GabiAndi/UNER_Tunel_de_viento/Simulacion/Fuente de corriente/Fuente de corriente.bmp

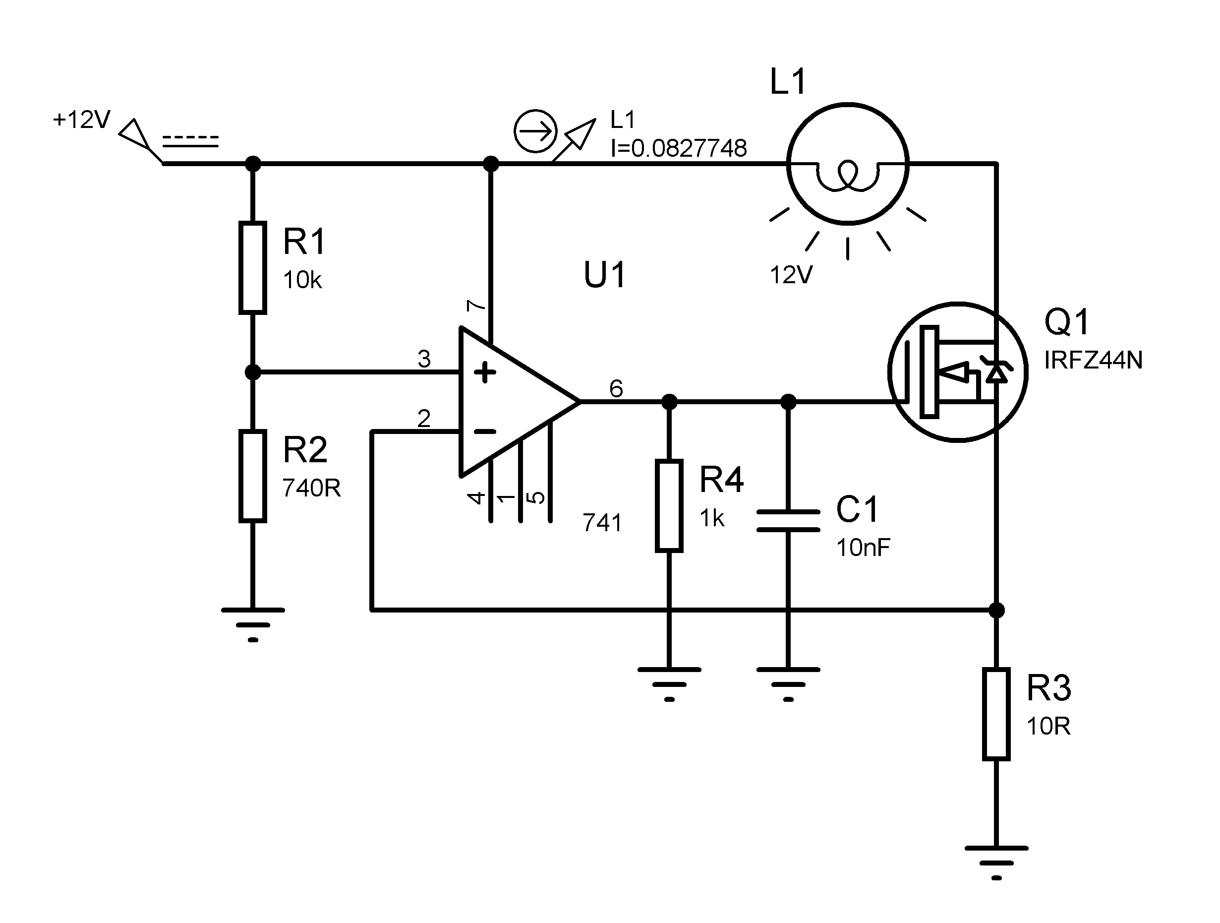
Simulacion/Fuente de corriente/Fuente de corriente.bmp
