GabiAndi/UNER_Tunel_de_viento/Simulacion/Linealizacion de NTC/Linealizacion de NTC.bmp

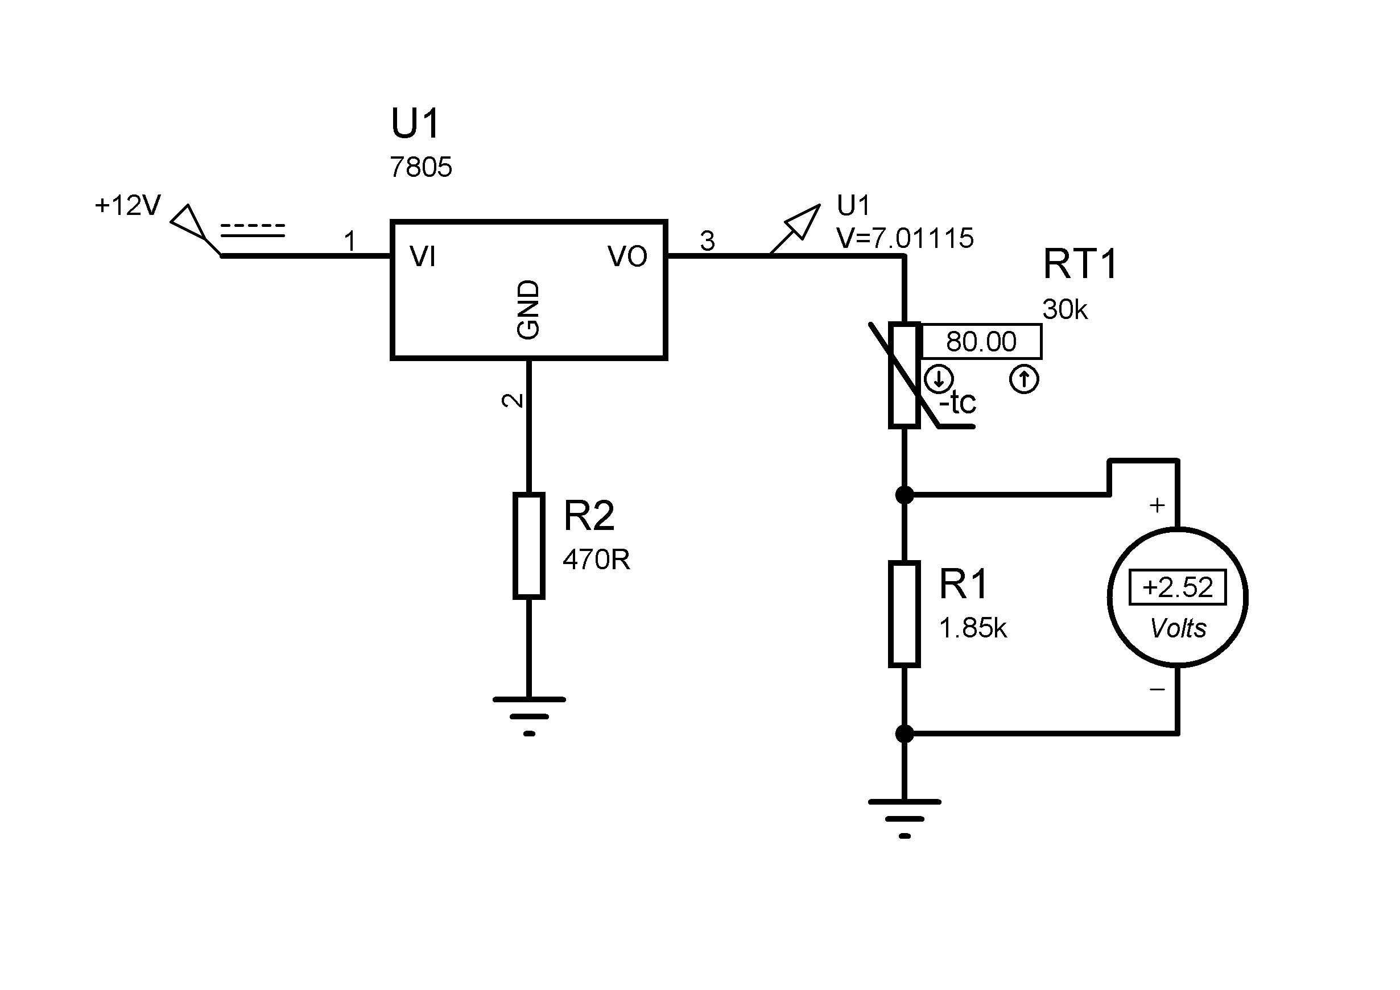
Simulacion/Linealizacion de NTC/Linealizacion de NTC.bmp
