GabiAndi/UNER_Tunel_de_viento/(list of files, drawings)

Other design files:
Simulacion/Clapeta/Clapeta.pdsprj
Simulacion/Fuente de corriente/Fuente de corriente.pdsprj
Simulacion/Linealizacion de NTC/Linealizacion de NTC.pdsprj
