GabiAndi/UNER_Tunel_de_viento/Esquemas/Esquematicos.sch

## EAGLE design Esquemas/Esquematicos.sch (2021-03-19)

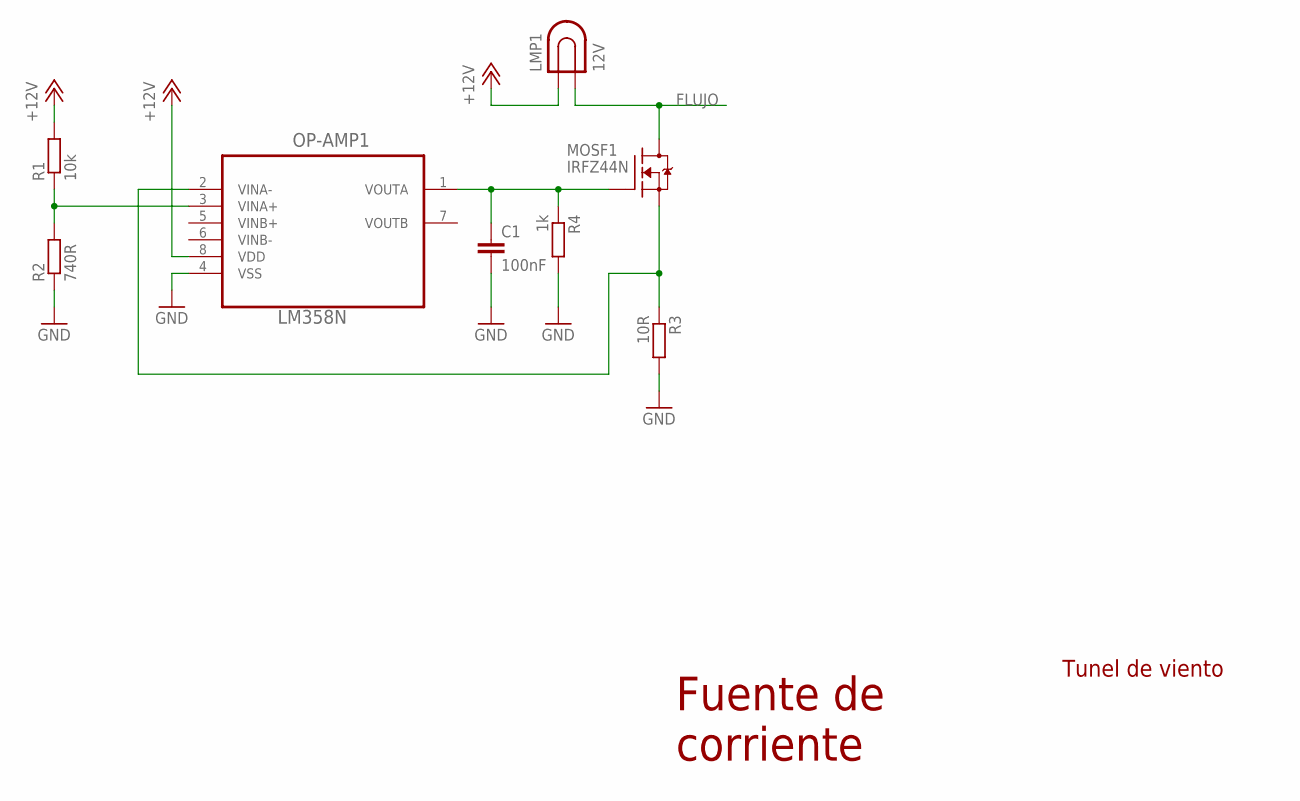
[picture p18: schematic Esquematicos.sch, sheet 1]

Parts:
C1: 100nF; C050-024X044
LMP1: 12V; LDH-5R
MOSF1: IRFZ44N; TO220V
OP-AMP1: LM358N; DIL8
R1: 10k; 0207/10
R2: 740R; 0207/10
R3: 10R; 0207/10
R4: 1k; 0207/10

Connections:
+12V: LMP1.1, OP-AMP1.8 (VDD), R1.2
FLUJO: LMP1.2, MOSF1.1 (D)
GND: C1.2, OP-AMP1.4 (VSS), R2.1, R3.2, R4.2
unnamed: OP-AMP1.3 (VINA+), R1.1, R2.2
unnamed: C1.1, MOSF1.2 (G), OP-AMP1.1 (VOUTA), R4.1
unnamed: MOSF1.3 (S), OP-AMP1.2 (VINA-), R3.1

Notes on the sheet:
Fuente de corriente
Tunel de viento

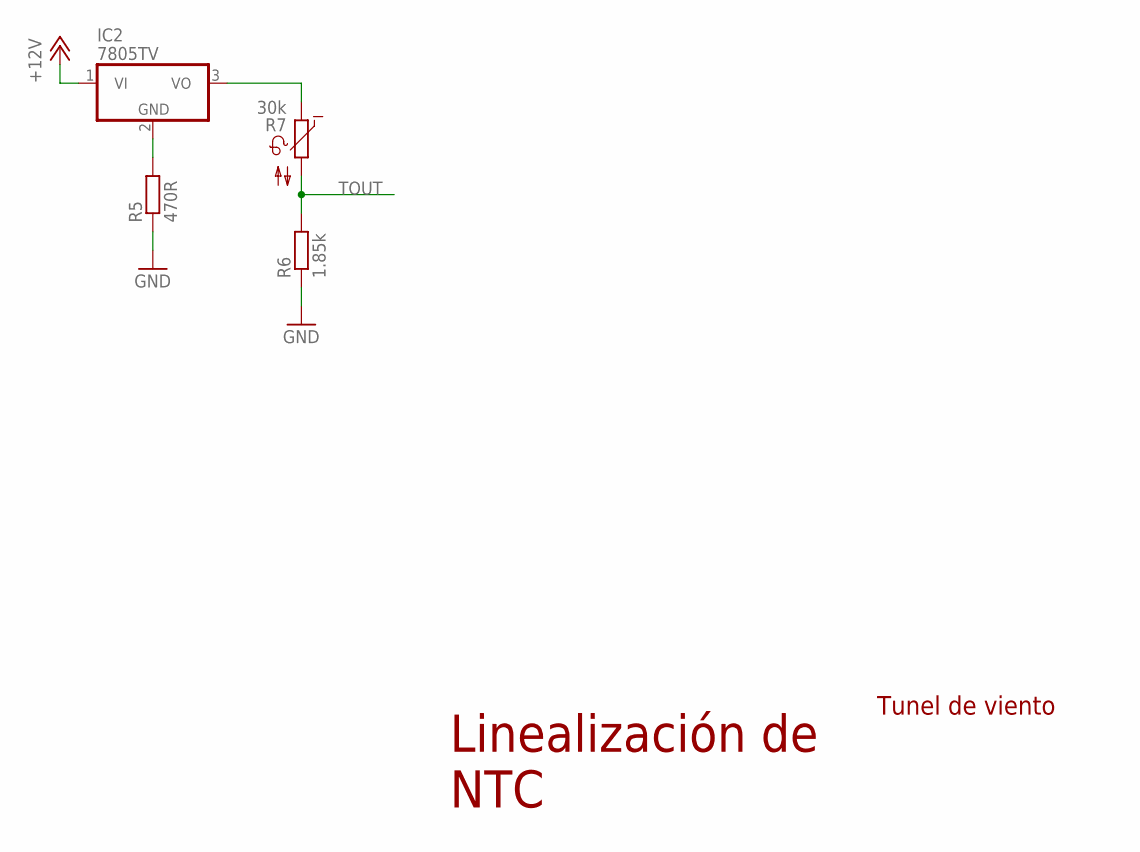
[picture p19: schematic Esquematicos.sch, sheet 2]

Parts:
IC2: 7805TV; TO220V
R5: 470R; 0207/10
R6: 1.85k; 0207/10
R7: 30k; P640

Connections:
+12V: IC2.1 (VI)
GND: R5.1, R6.1
unnamed: IC2.2 (GND), R5.2
unnamed: IC2.3 (VO), R7.1
TOUT: R6.2, R7.2

Notes on the sheet:
Linealización de NTC
Tunel de viento

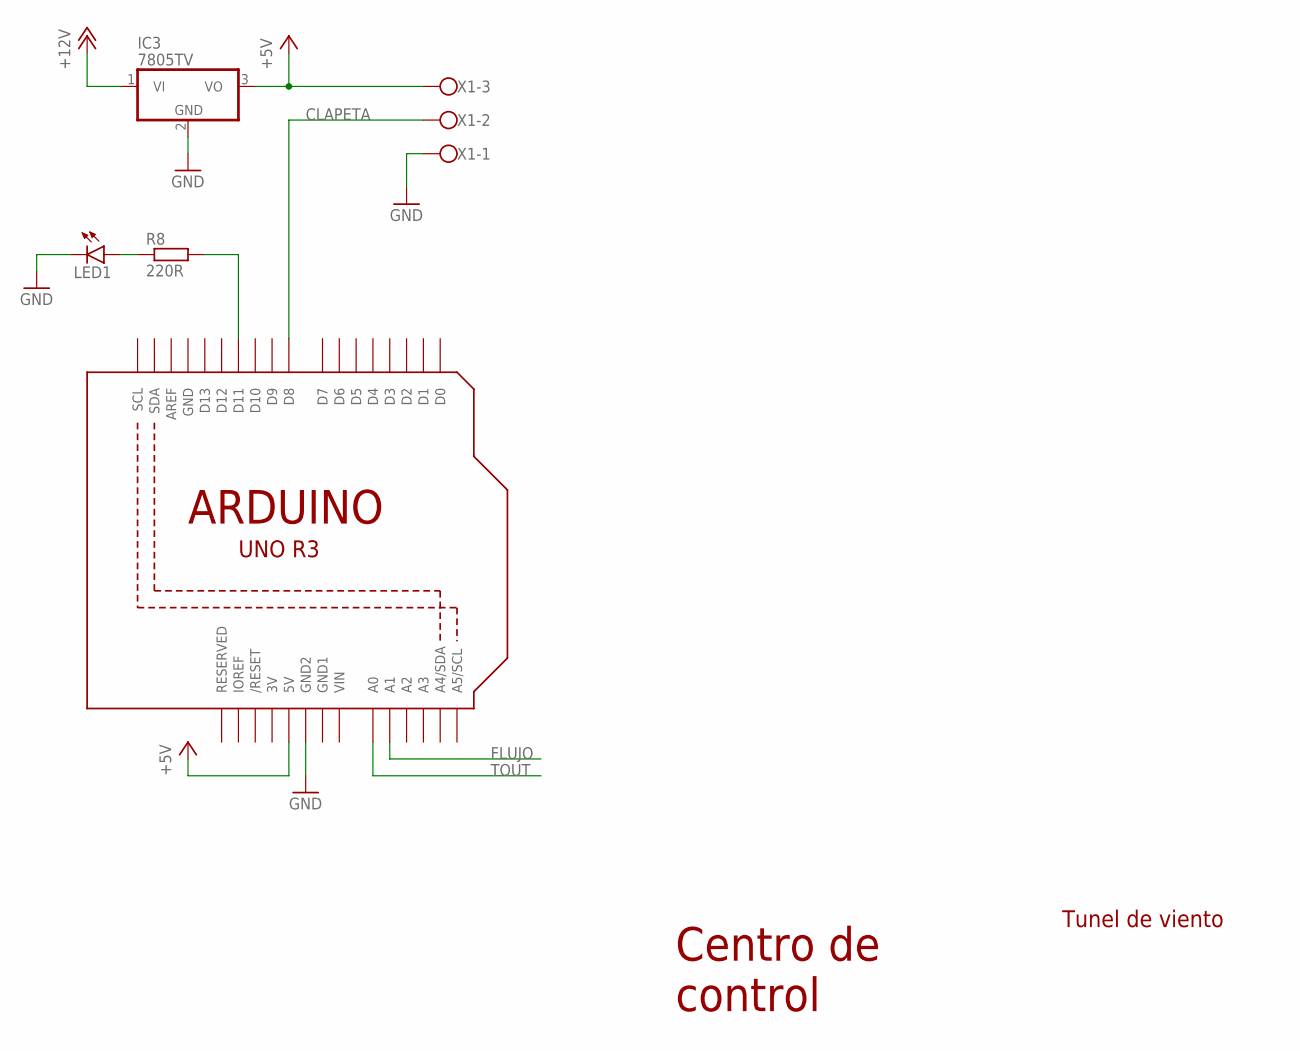
[picture p20: schematic Esquematicos.sch, sheet 3]

Parts:
IC3: 7805TV; TO220V
LED1: LED5MM
R8: 220R; 0204/7
U1: ARDUINOR3-BPLACE
X1: W237-103

Connections:
+5V: IC3.3 (VO), U1.5V, X1.3
+12V: IC3.1 (VI)
CLAPETA: U1.D8, X1.2
FLUJO: U1.A1
GND: IC3.2 (GND), LED1.K (C), U1.GND2, X1.1
unnamed: LED1.A, R8.1
unnamed: R8.2, U1.D11
TOUT: U1.A0

Notes on the sheet:
Centro de control
Tunel de viento
